vonsivers/8x8-haptic-wordclock/stl/letters/Letters_haptic wordclock 8x8 assembly v16_Körper21_Letters.stl

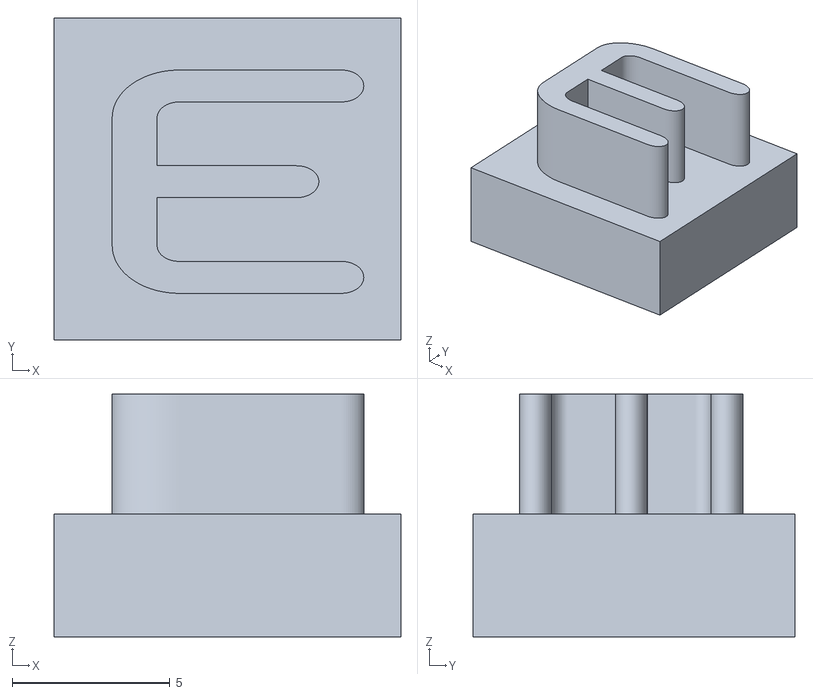
[picture p5: CAD file, 2021-04-09]
stl/letters/Letters_haptic wordclock 8x8 assembly v16_Körper21_Letters.stl
11.0 x 10.2 x 7.70
