vonsivers/8x8-haptic-wordclock/PCBs/haptic display/haptic display 4x4/haptic display.step

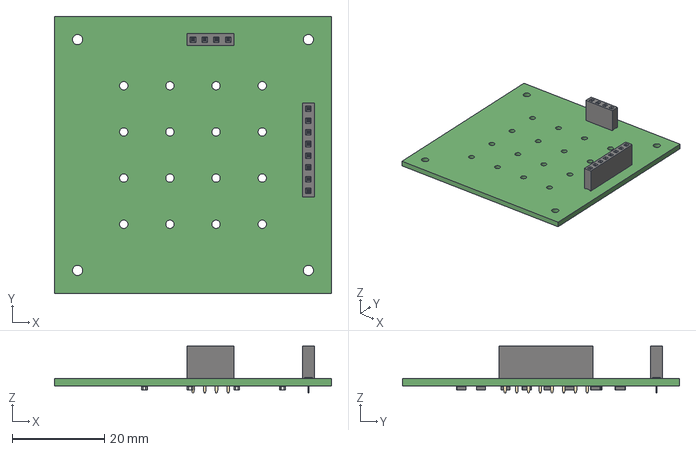
[picture p11: CAD file, 2021-01-10]
PCBs/haptic display/haptic display 4x4/haptic display.step
60.0 x 60.0 x 10.1 mm
