vonsivers/8x8-haptic-wordclock/PCBs/haptic display/haptic display 8x8/haptic display 8x8 coil matrix/haptic display 8x8 aisler.step

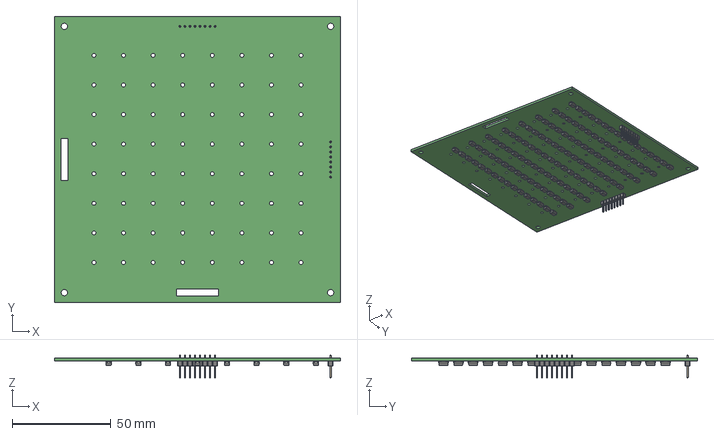
[picture p12: CAD file, 2021-01-10]
PCBs/haptic display/haptic display 8x8/haptic display 8x8 coil matrix/haptic display 8x8 aisler.step
145.0 x 145.0 x 11.5 mm
