vonsivers/8x8-haptic-wordclock/PCBs/haptic display/haptic display 8x8/haptic display 8x8 driver/haptic display 8x8 driver.step

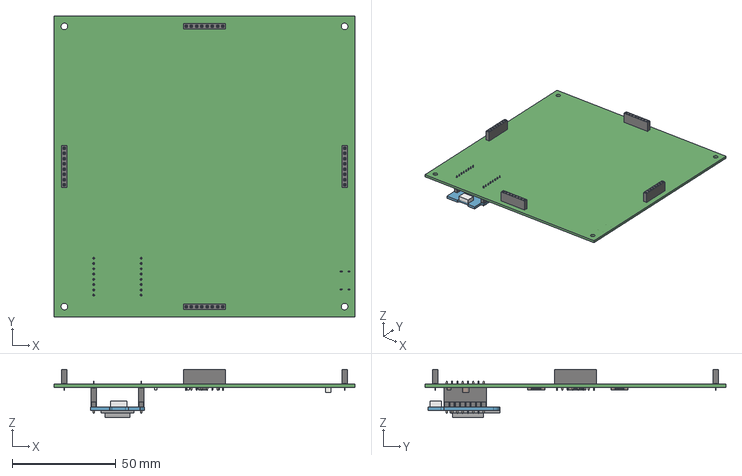
[picture p13: CAD file, 2021-01-10]
PCBs/haptic display/haptic display 8x8/haptic display 8x8 driver/haptic display 8x8 driver.step
145.0 x 145.0 x 23.3 mm
