vonsivers/8x8-haptic-wordclock/stl/frontplate.stl

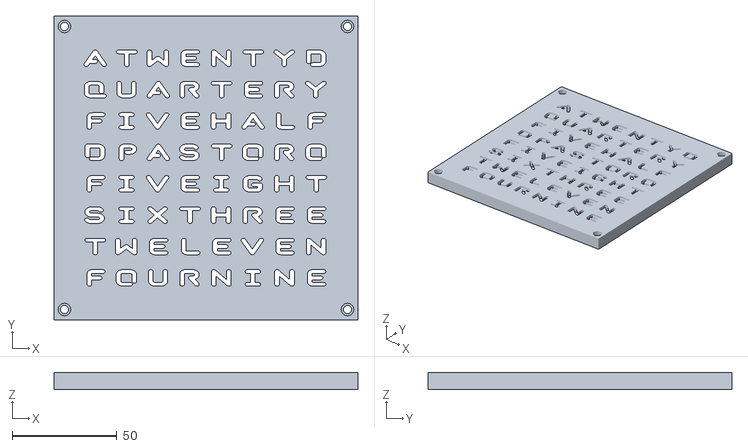
[picture p14: CAD file, 2021-04-09]
stl/frontplate.stl
145.0 x 145.0 x 8.20
