vonsivers/8x8-haptic-wordclock/stl/magnetholder_4,4x6.stl

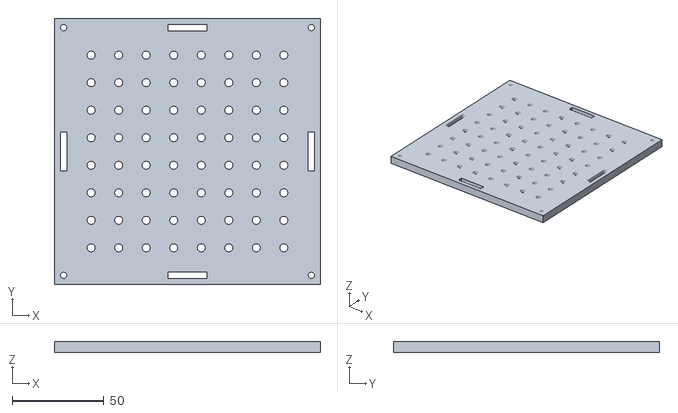
[picture p15: CAD file, 2021-03-28]
stl/magnetholder_4,4x6.stl
145.0 x 145.0 x 6.00
