vonsivers/8x8-haptic-wordclock/stl/backplate.stl

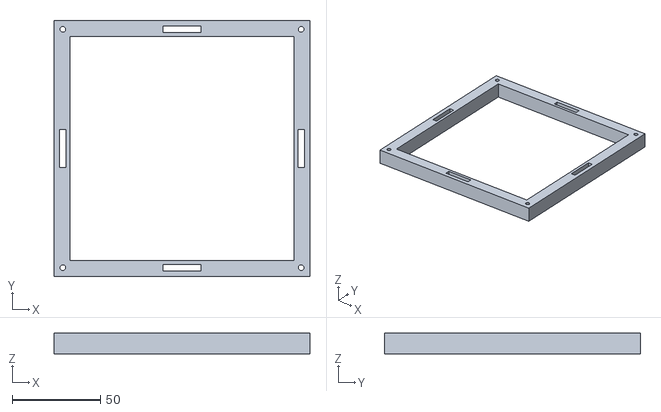
[picture p16: CAD file, 2021-03-28]
stl/backplate.stl
145.0 x 145.0 x 11.6
