vonsivers/8x8-haptic-wordclock/(list of files, cad)

Other CAD files:
stl/letters/Letters_haptic wordclock 8x8 assembly v16_Körper65_Letters.stl
stl/letters/Letters_haptic wordclock 8x8 assembly v16_Körper13_Letters.stl
stl/letters/Letters_haptic wordclock 8x8 assembly v16_Körper18_Letters.stl
stl/letters/Letters_haptic wordclock 8x8 assembly v16_Körper35_Letters.stl
stl/letters/Letters_haptic wordclock 8x8 assembly v16_Körper40_Letters.stl
stl/letters/Letters_haptic wordclock 8x8 assembly v16_Körper10_Letters.stl
stl/letters/Letters_haptic wordclock 8x8 assembly v16_Körper22_Letters.stl
stl/letters/Letters_haptic wordclock 8x8 assembly v16_Körper15_Letters.stl
stl/letters/Letters_haptic wordclock 8x8 assembly v16_Körper23_Letters.stl
stl/letters/Letters_haptic wordclock 8x8 assembly v16_Körper19_Letters.stl
stl/letters/Letters_haptic wordclock 8x8 assembly v16_Körper60_Letters.stl
stl/letters/Letters_haptic wordclock 8x8 assembly v16_Körper52_Letters.stl
stl/letters/Letters_haptic wordclock 8x8 assembly v16_Körper50_Letters.stl
stl/letters/Letters_haptic wordclock 8x8 assembly v16_Körper54_Letters.stl
stl/letters/Letters_haptic wordclock 8x8 assembly v16_Körper8_Letters.stl
stl/letters/Letters_haptic wordclock 8x8 assembly v16_Körper53_Letters.stl
stl/letters/Letters_haptic wordclock 8x8 assembly v16_Körper1_Letters.stl
stl/letters/Letters_haptic wordclock 8x8 assembly v16_Körper57_Letters.stl
stl/letters/Letters_haptic wordclock 8x8 assembly v16_Körper36_Letters.stl
stl/letters/Letters_haptic wordclock 8x8 assembly v16_Körper55_Letters.stl
stl/letters/Letters_haptic wordclock 8x8 assembly v16_Körper59_Letters.stl
stl/letters/Letters_haptic wordclock 8x8 assembly v16_Körper45_Letters.stl
stl/letters/Letters_haptic wordclock 8x8 assembly v16_Körper49_Letters.stl
stl/letters/Letters_haptic wordclock 8x8 assembly v16_Körper48_Letters.stl
stl/letters/Letters_haptic wordclock 8x8 assembly v16_Körper25_Letters.stl
stl/letters/Letters_haptic wordclock 8x8 assembly v16_Körper24_Letters.stl
stl/letters/Letters_haptic wordclock 8x8 assembly v16_Körper56_Letters.stl
stl/letters/Letters_haptic wordclock 8x8 assembly v16_Körper61_Letters.stl
stl/letters/Letters_haptic wordclock 8x8 assembly v16_Körper28_Letters.stl
stl/letters/Letters_haptic wordclock 8x8 assembly v16_Körper63_Letters.stl
stl/letters/Letters_haptic wordclock 8x8 assembly v16_Körper26_Letters.stl
stl/letters/Letters_haptic wordclock 8x8 assembly v16_Körper58_Letters.stl
stl/letters/Letters_haptic wordclock 8x8 assembly v16_Körper12_Letters.stl
stl/letters/Letters_haptic wordclock 8x8 assembly v16_Körper7_Letters.stl
stl/letters/Letters_haptic wordclock 8x8 assembly v16_Körper4_Letters.stl
stl/letters/Letters_haptic wordclock 8x8 assembly v16_Körper29_Letters.stl
stl/letters/Letters_haptic wordclock 8x8 assembly v16_Körper34_Letters.stl
stl/letters/Letters_haptic wordclock 8x8 assembly v16_Körper44_Letters.stl
stl/letters/Letters_haptic wordclock 8x8 assembly v16_Körper43_Letters.stl
stl/letters/Letters_haptic wordclock 8x8 assembly v16_Körper27_Letters.stl
stl/letters/Letters_haptic wordclock 8x8 assembly v16_Körper41_Letters.stl
stl/letters/Letters_haptic wordclock 8x8 assembly v16_Körper30_Letters.stl
stl/letters/Letters_haptic wordclock 8x8 assembly v16_Körper33_Letters.stl
stl/letters/Letters_haptic wordclock 8x8 assembly v16_Körper47_Letters.stl
stl/letters/Letters_haptic wordclock 8x8 assembly v16_Körper32_Letters.stl
stl/letters/Letters_haptic wordclock 8x8 assembly v16_Körper42_Letters.stl
stl/letters/Letters_haptic wordclock 8x8 assembly v16_Körper51_Letters.stl
stl/letters/Letters_haptic wordclock 8x8 assembly v16_Körper62_Letters.stl
stl/letters/Letters_haptic wordclock 8x8 assembly v16_Körper37_Letters.stl
stl/letters/Letters_haptic wordclock 8x8 assembly v16_Körper5_Letters.stl
stl/letters/Letters_haptic wordclock 8x8 assembly v16_Körper16_Letters.stl
stl/letters/Letters_haptic wordclock 8x8 assembly v16_Körper3_Letters.stl
stl/letters/Letters_haptic wordclock 8x8 assembly v16_Körper6_Letters.stl
stl/letters/Letters_haptic wordclock 8x8 assembly v16_Körper9_Letters.stl
