vonsivers/8x8-haptic-wordclock/PCBs/haptic display/haptic display 8x8/haptic display 8x8 driver/haptic display 8x8 driver.kicad_pcb

## KiCad design PCBs/haptic display/haptic display 8x8/haptic display 8x8 driver/haptic display 8x8 driver.kicad_pcb (2021-03-28)

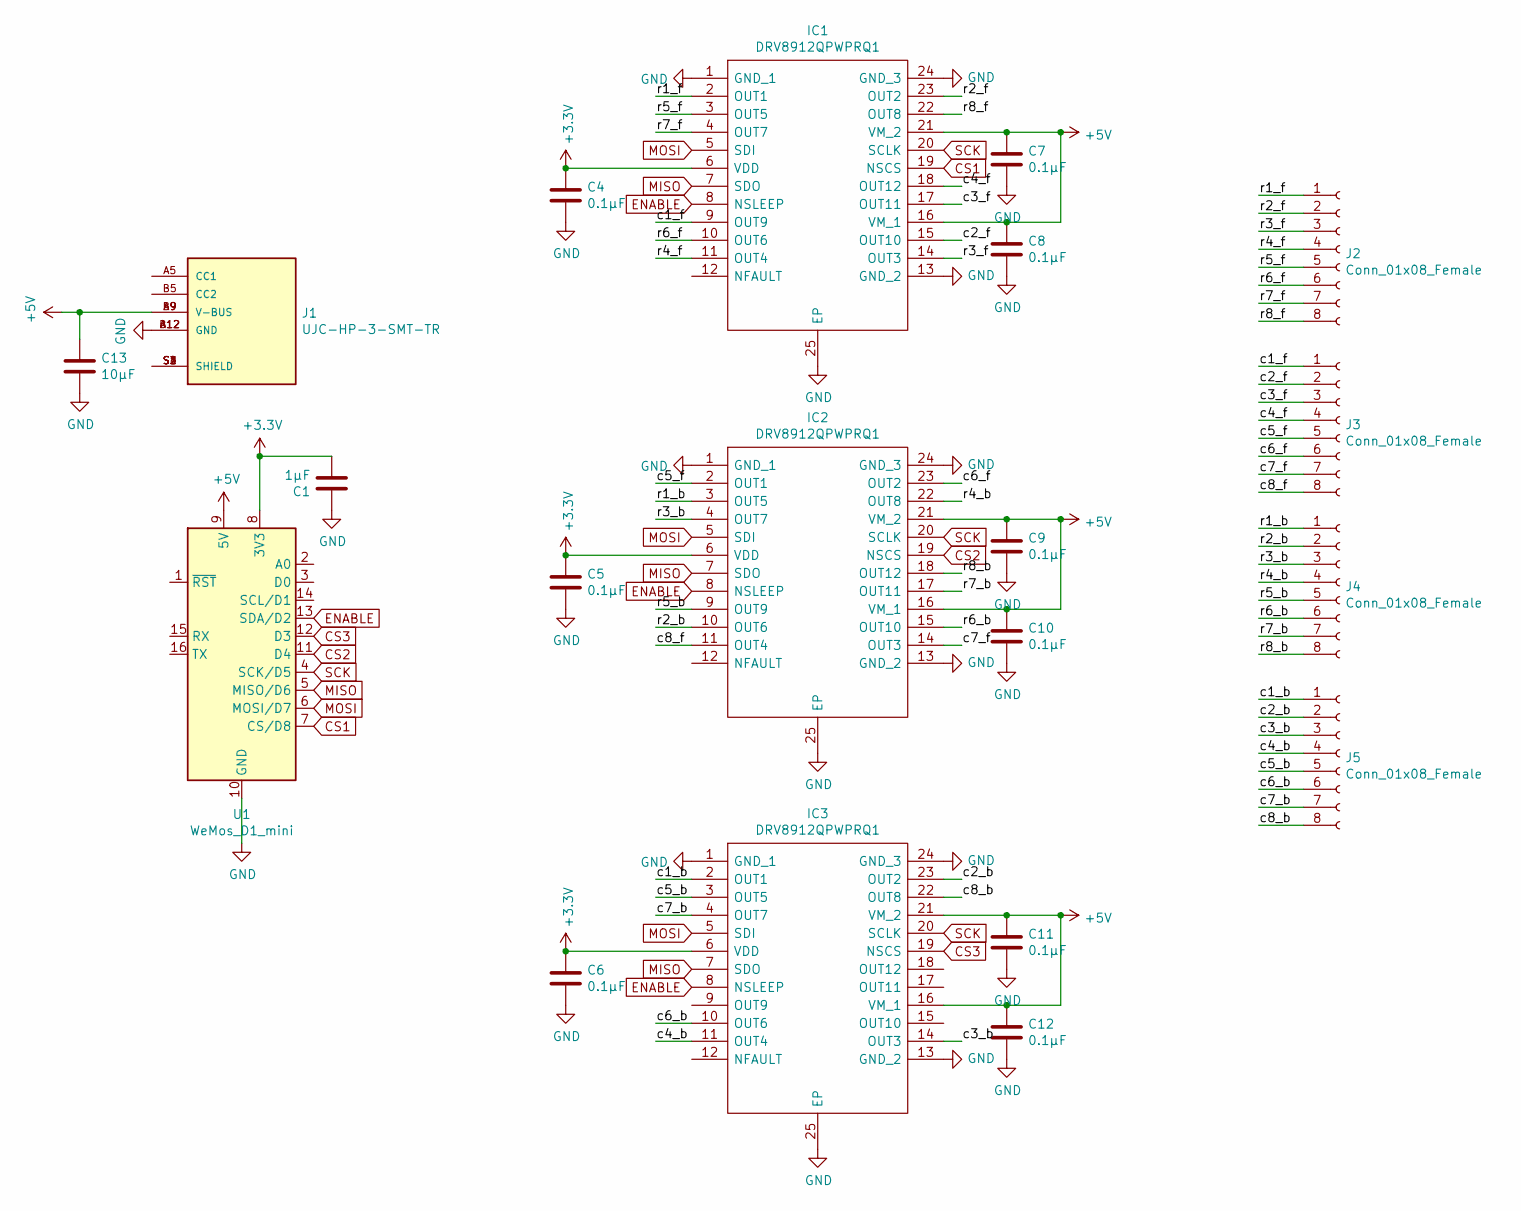
[picture p17: schematic haptic display 8x8 driver.sch]

Parts:
C1: 1µF; C_0805_2012Metric
C4, C5, C6, C7, C8, C9, C10, C11, C12: 0.1µF; C_0805_2012Metric
C13: 10µF; C_1210_3225Metric
IC1, IC2, IC3: DRV8912QPWPRQ1; SOP65P640X120-25N; Mouser Part Number 595-DRV8912QPWPRQ1
J1: UJC-HP-3-SMT-TR; CUI_UJC-HP-3-SMT-TR; PARTREV 1.0
J2, J3, J4, J5: Conn_01x08_Female; PinSocket_1x08_P2.54mm_Vertical
U1: WeMos_D1_mini; WEMOS_D1_mini_light

Connections:
+3V3: C1.2, C4.1, C5.1, C6.1, IC1.6 (VDD), IC2.6 (VDD), IC3.6 (VDD), U1.8 (3V3)
+5V: C7.1, C8.1, C9.1, C10.1, C11.1, C12.1, C13.1, IC1.16 (VM_1), IC1.21 (VM_2), IC2.16 (VM_1), IC2.21 (VM_2), IC3.16 (VM_1), IC3.21 (VM_2), J1.A9 (V-BUS), J1.B9 (V-BUS), U1.9 (5V)
/c1_b: IC3.2 (OUT1), J5.1
/c1_f: IC1.9 (OUT9), J3.1
/c2_b: IC3.23 (OUT2), J5.2
/c2_f: IC1.15 (OUT10), J3.2
/c3_b: IC3.14 (OUT3), J5.3
/c3_f: IC1.17 (OUT11), J3.3
/c4_b: IC3.11 (OUT4), J5.4
/c4_f: IC1.18 (OUT12), J3.4
/c5_b: IC3.3 (OUT5), J5.5
/c5_f: IC2.2 (OUT1), J3.5
/c6_b: IC3.10 (OUT6), J5.6
/c6_f: IC2.23 (OUT2), J3.6
/c7_b: IC3.4 (OUT7), J5.7
/c7_f: IC2.14 (OUT3), J3.7
/c8_b: IC3.22 (OUT8), J5.8
/c8_f: IC2.11 (OUT4), J3.8
/r1_b: IC2.3 (OUT5), J4.1
/r1_f: IC1.2 (OUT1), J2.1
/r2_b: IC2.10 (OUT6), J4.2
/r2_f: IC1.23 (OUT2), J2.2
/r3_b: IC2.4 (OUT7), J4.3
/r3_f: IC1.14 (OUT3), J2.3
/r4_b: IC2.22 (OUT8), J4.4
/r4_f: IC1.11 (OUT4), J2.4
/r5_b: IC2.9 (OUT9), J4.5
/r5_f: IC1.3 (OUT5), J2.5
/r6_b: IC2.15 (OUT10), J4.6
/r6_f: IC1.10 (OUT6), J2.6
/r7_b: IC2.17 (OUT11), J4.7
/r7_f: IC1.4 (OUT7), J2.7
/r8_b: IC2.18 (OUT12), J4.8
/r8_f: IC1.22 (OUT8), J2.8
CS1: IC1.19 (NSCS), U1.7 (CS/D8)
CS2: IC2.19 (NSCS), U1.11 (D4)
CS3: IC3.19 (NSCS), U1.12 (D3)
ENABLE: IC1.8 (NSLEEP), IC2.8 (NSLEEP), IC3.8 (NSLEEP), U1.13 (SDA/D2)
GND: C1.1, C4.2, C5.2, C6.2, C7.2, C8.2, C9.2, C10.2, C11.2, C12.2, C13.2, IC1.1 (GND_1), IC1.13 (GND_2), IC1.24 (GND_3), IC1.25 (EP), IC2.1 (GND_1), IC2.13 (GND_2), IC2.24 (GND_3), IC2.25 (EP), IC3.1 (GND_1), IC3.13 (GND_2), IC3.24 (GND_3), IC3.25 (EP), J1.A12 (GND), J1.B12 (GND), U1.10 (GND)
MISO: IC1.7 (SDO), IC2.7 (SDO), IC3.7 (SDO), U1.5 (MISO/D6)
MOSI: IC1.5 (SDI), IC2.5 (SDI), IC3.5 (SDI), U1.6 (MOSI/D7)
unnamed: J1.S1 (SHIELD), J1.S2 (SHIELD), J1.S3 (SHIELD), J1.S4 (SHIELD)
SCK: IC1.20 (SCLK), IC2.20 (SCLK), IC3.20 (SCLK), U1.4 (SCK/D5)

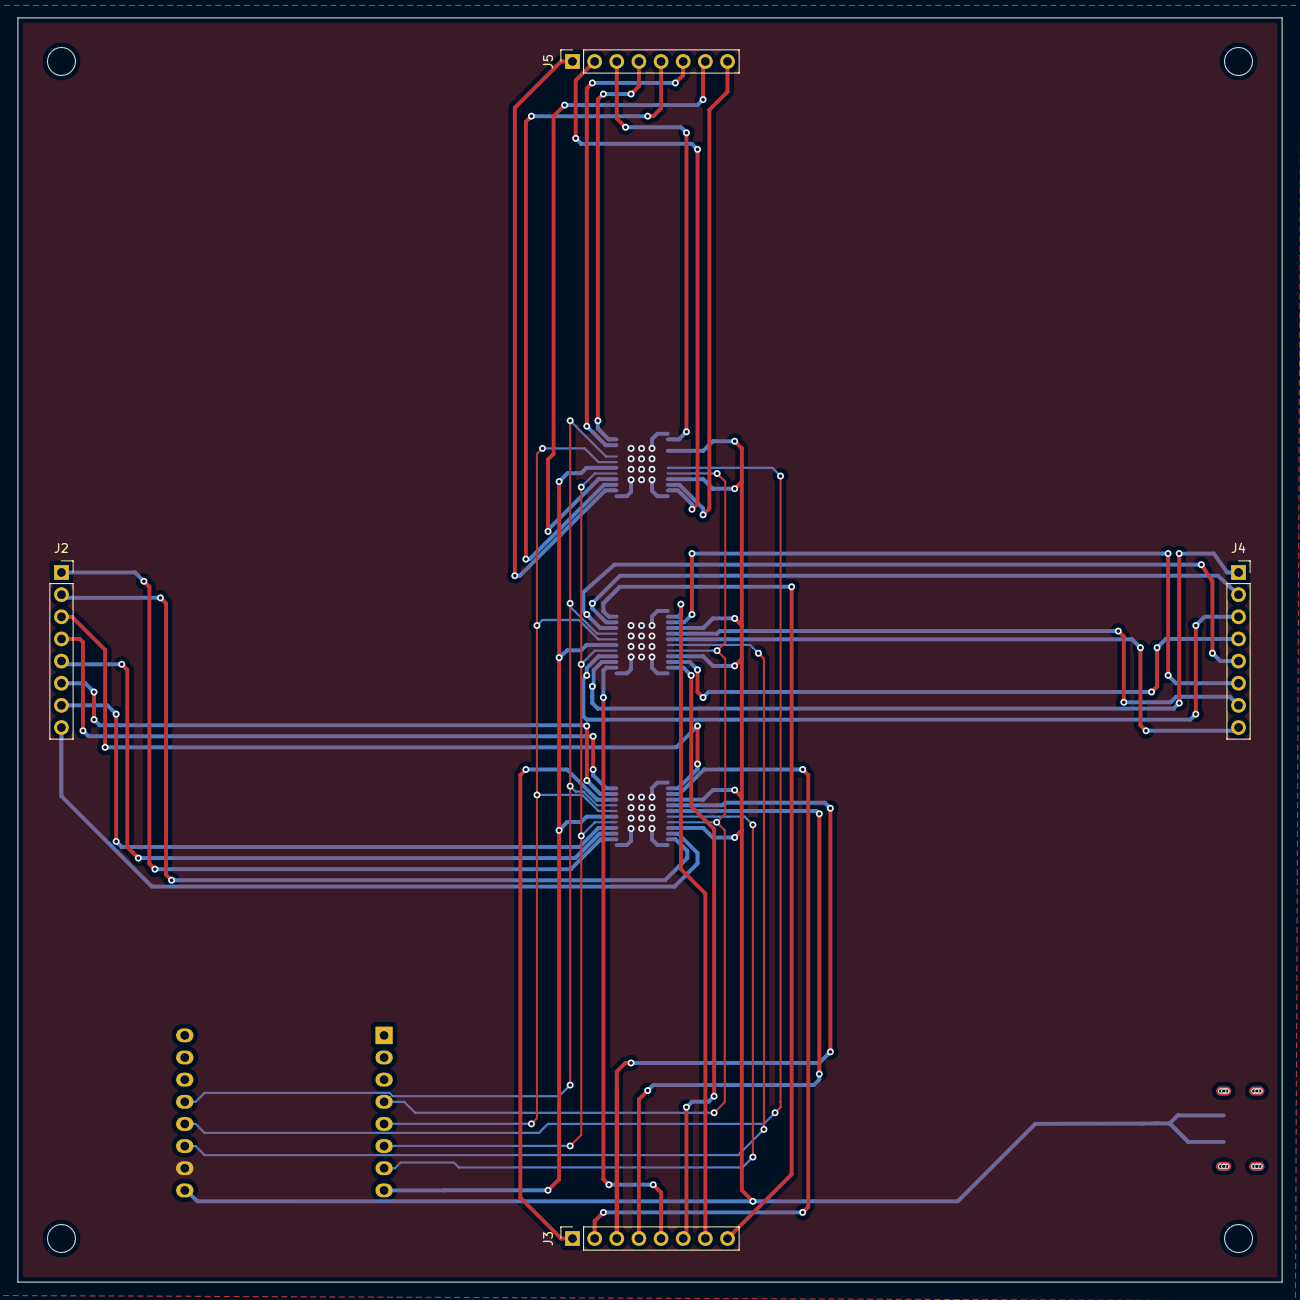
[picture p18: board haptic display 8x8 driver.kicad_pcb from above]

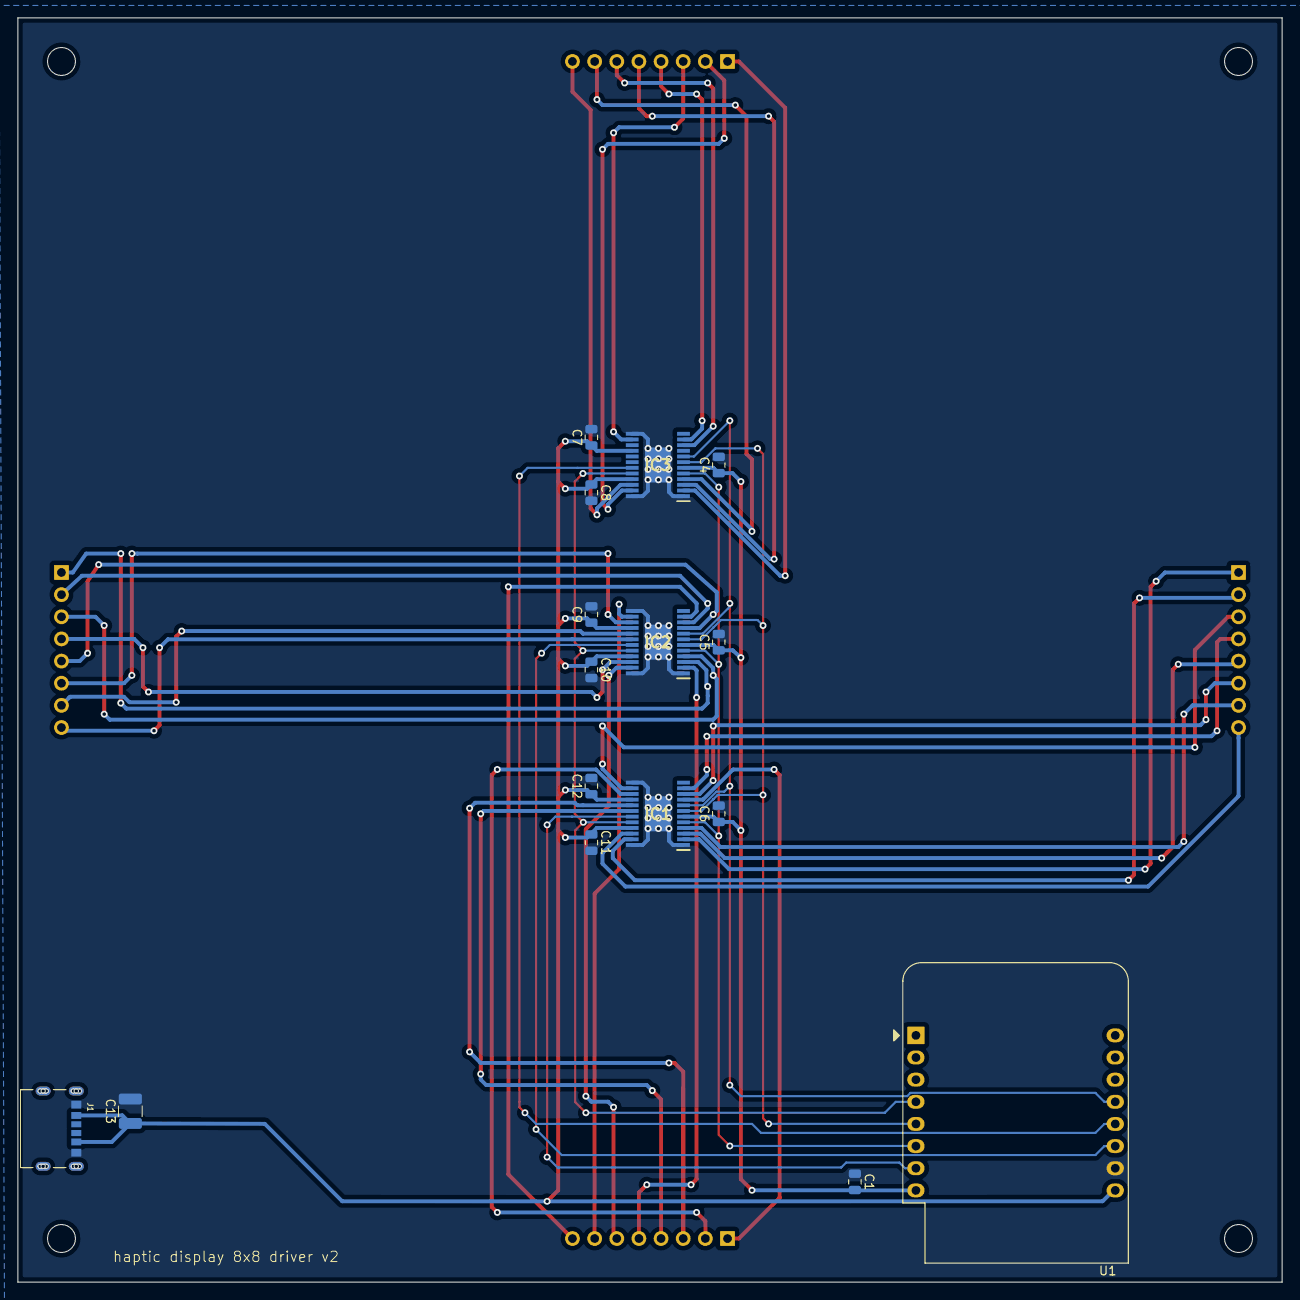
[picture p19: board haptic display 8x8 driver.kicad_pcb from below]

Board: 2 copper layers, 145.0 x 145.0 mm, 20 parts (16 on the bottom side), 43 nets.
