vonsivers/8x8-haptic-wordclock/PCBs/haptic display/haptic display 4x4/haptic display.kicad_pcb

## KiCad design PCBs/haptic display/haptic display 4x4/haptic display.kicad_pcb (2021-01-10)

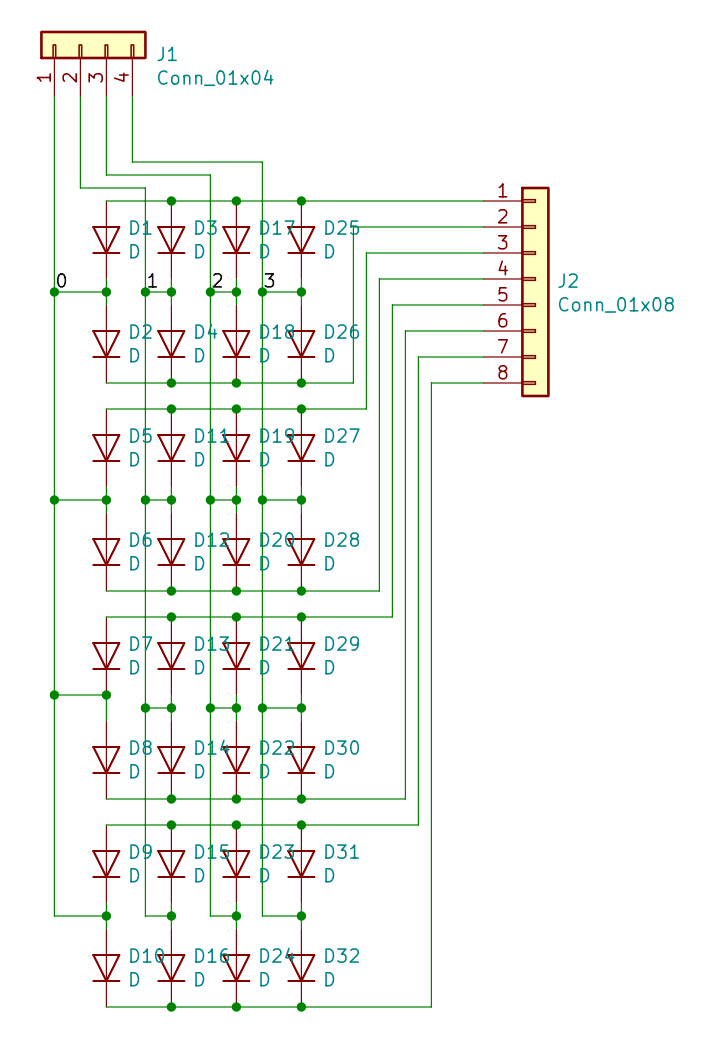
[picture p20: schematic haptic display.sch]

Parts:
D1, D2, D3, D4, D5, D6, D7, D8, D9, D10, D11, D12, D13, D14, D15, D16, D17, D18, D19, D20, D21, D22, D23, D24, D25, D26, D27, D28, D29, D30, D31, D32: D; D_0805_2012Metric
J1: Conn_01x04; PinSocket_1x04_P2.54mm_Vertical
J2: Conn_01x08; PinSocket_1x08_P2.54mm_Vertical

Connections:
/0: D1.1 (K), D2.2 (A), D5.1 (K), D6.2 (A), D7.1 (K), D8.2 (A), D9.1 (K), D10.2 (A), J1.1
/1: D3.1 (K), D4.2 (A), D11.1 (K), D12.2 (A), D13.1 (K), D14.2 (A), D15.1 (K), D16.2 (A), J1.2
/2: D17.1 (K), D18.2 (A), D19.1 (K), D20.2 (A), D21.1 (K), D22.2 (A), D23.1 (K), D24.2 (A), J1.3
/3: D25.1 (K), D26.2 (A), D27.1 (K), D28.2 (A), D29.1 (K), D30.2 (A), D31.1 (K), D32.2 (A), J1.4
unnamed: D1.2 (A), D3.2 (A), D17.2 (A), D25.2 (A), J2.1
unnamed: D10.1 (K), D16.1 (K), D24.1 (K), D32.1 (K), J2.8
unnamed: D5.2 (A), D11.2 (A), D19.2 (A), D27.2 (A), J2.3
unnamed: D6.1 (K), D12.1 (K), D20.1 (K), D28.1 (K), J2.4
unnamed: D7.2 (A), D13.2 (A), D21.2 (A), D29.2 (A), J2.5
unnamed: D8.1 (K), D14.1 (K), D22.1 (K), D30.1 (K), J2.6
unnamed: D9.2 (A), D15.2 (A), D23.2 (A), D31.2 (A), J2.7
unnamed: D2.1 (K), D4.1 (K), D18.1 (K), D26.1 (K), J2.2

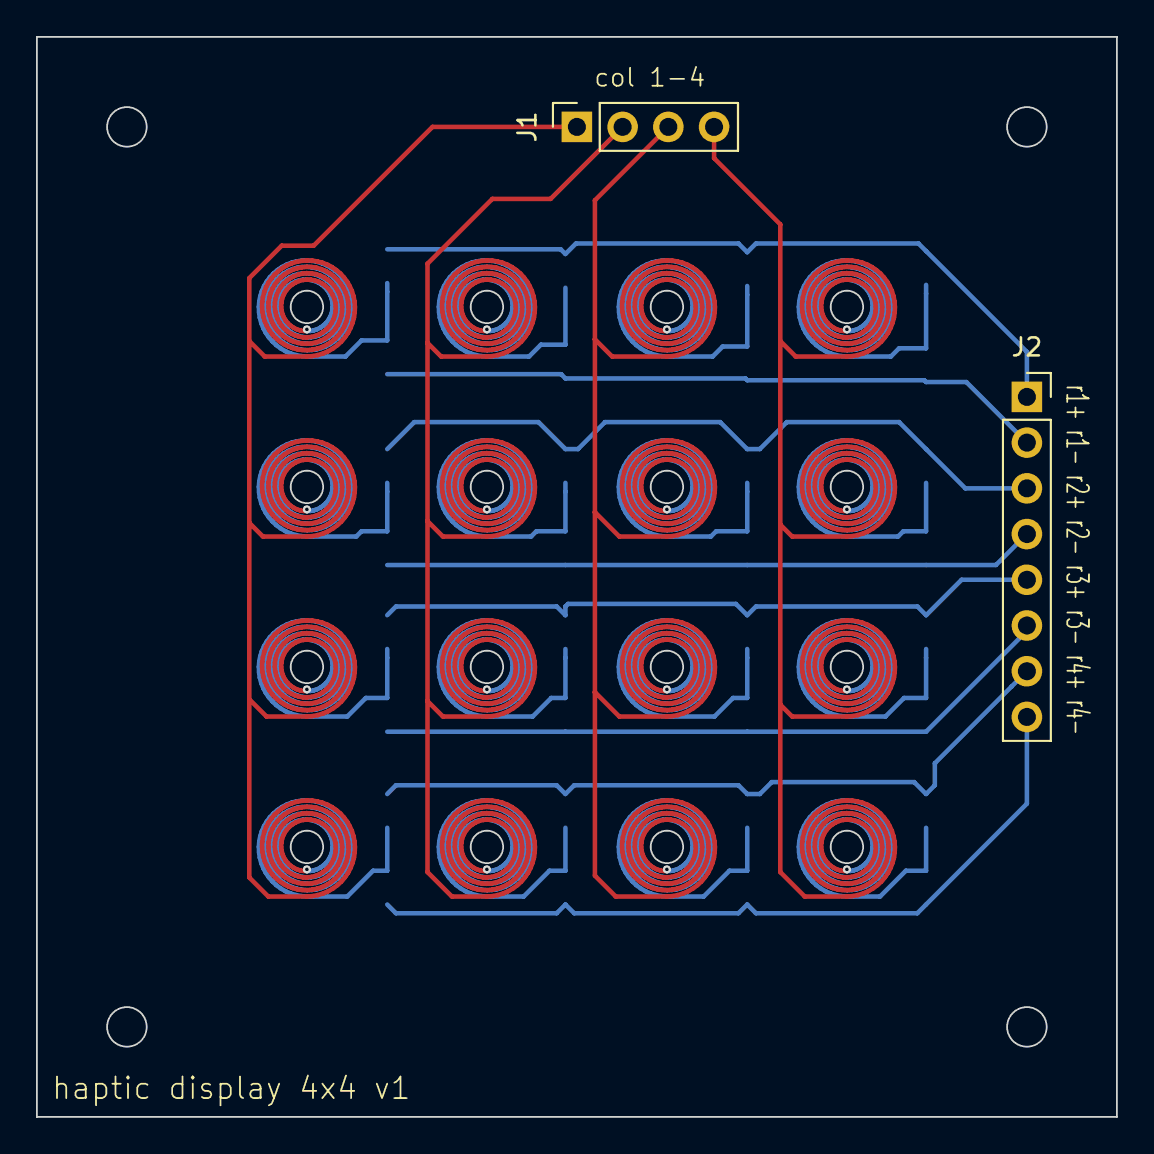
[picture p21: board haptic display.kicad_pcb from above]

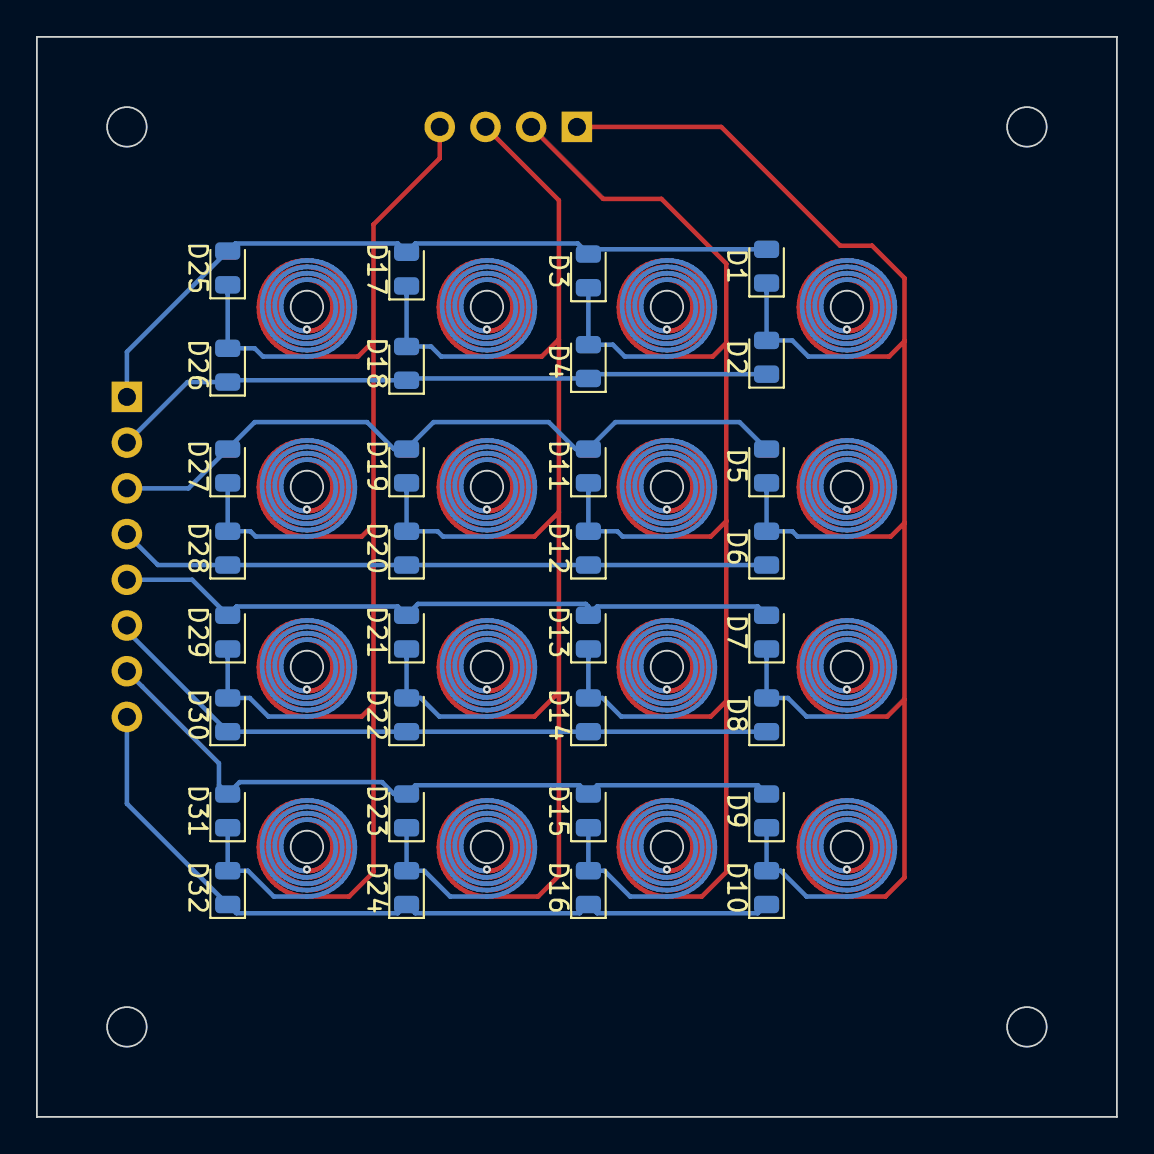
[picture p22: board haptic display.kicad_pcb from below]

Board: 2 copper layers, 60.0 x 60.0 mm, 34 parts (32 on the bottom side), 12 nets.
